EricBabatunde/MaizePlanterRepo/PScontrollerTests/controllerTest2/WhatsApp Image 2026-01-18 at 15.10.30.jpeg

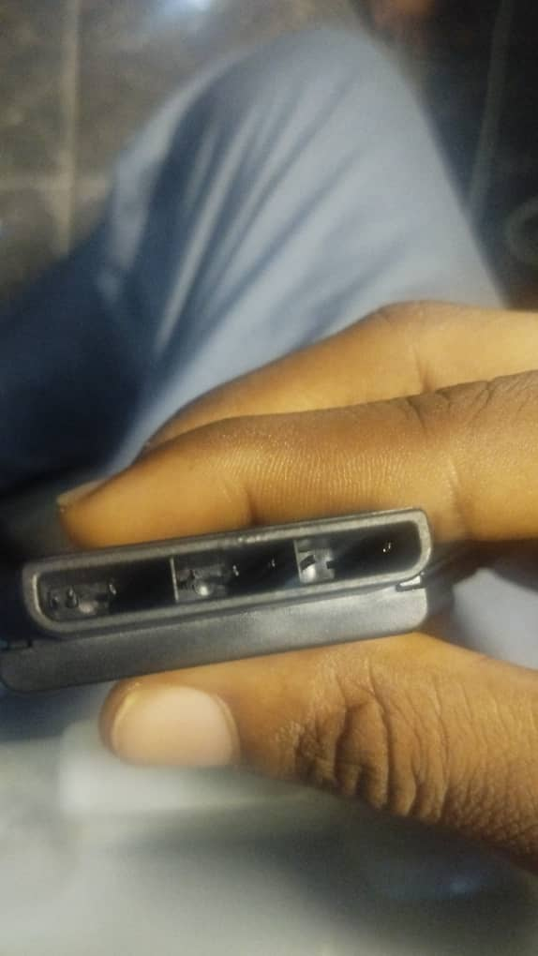
PScontrollerTests/controllerTest2/WhatsApp Image 2026-01-18 at 15.10.30.jpeg
