EricBabatunde/MaizePlanterRepo/PScontrollerTests/controllerTest2/WhatsApp Image 2026-01-18 at 15.08.40.jpeg

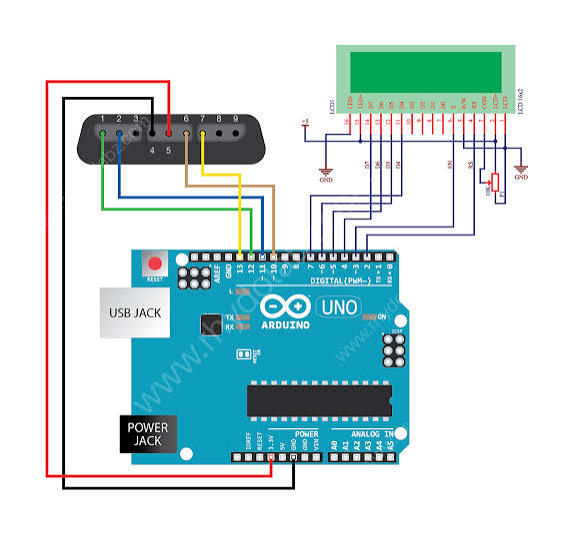
PScontrollerTests/controllerTest2/WhatsApp Image 2026-01-18 at 15.08.40.jpeg
