EricBabatunde/MaizePlanterRepo/README.md

# AutoMaizePublic
This repository contains all the code for the Automated Maize Seed Planter.
