EricBabatunde/MaizePlanterRepo/PScontrollerTests/controllerTest7/Controller controls.pdf

## Controller controls

Input | Function | Logic
Left Stick Y | Left Motor Throttle | Direct control of Left Wheels.
Right Stick Y | Right Motor Throttle | Direct control of Right Wheels.
Difference (L-R) | Press Wheel Angle | Calculates steering angle based on stick difference.
L1 Button | U-Turn Mode | Sets Press Wheel to steering angle, drives right motor and locks left wheel for a left turn
R1 Button | U-Turn Mode | Sets Press Wheel to steering angle, drives left motor and locks right wheel for a left turn
Triangle (Green) | E-Stop / Brake | Immediately cuts power to all motors.
Circle | Planting (Pulse) | Runs metering plate for one cycle (drop seed).
Cross (Blue) | Cruise Control | Locks both motors to Fixed Forward Speed (e.g., planting speed).
