EricBabatunde/MaizePlanterRepo/data analysis/data/TurnTest_Log.csv

Direction | Duration_ms
Pivot_Left | 1267
Pivot_Right | 5150
Pivot_Left | 1919
Pivot_Right | 2237
