EricBabatunde/MaizePlanterRepo/data analysis/data/TurnTest_Run1 (1).csv

Phase | Duration_ms
Deceleration | 1407
Pivot_Left | 8401
Re-alignment | 1802
Acceleration | 801
