EricBabatunde/MaizePlanterRepo/data analysis/data/TurnTest_Run2.csv

Phase | Duration_ms
Deceleration | 1401
Pivot_Right | 8401
Re-alignment | 1801
Acceleration | 801
