EricBabatunde/MaizePlanterRepo/module1_finalv3PIO/module1_finalv3PIO/src/DataLogger.h

#pragma once
#include "Config.h"
#include <Arduino.h>

// Mount LittleFS
void initLogger();

// Generates a new file name and writes the CSV header
void startNewLogFile(String bracketName);

// Appends a new data point to the current run file
void logToFS(int pwm, float speed, float amps);

void logTurnEvent(String direction, unsigned long duration);
void startTelemetryLog();
void logTelemetry(int interval);
void logJamEvent(unsigned long timestamp);
