EricBabatunde/MaizePlanterRepo/(commit log)

2026-06-15 motors control pixhawk arm through remote gcs
2026-06-16 6 tests run - littlefs logs
    [BracketA_Run1 (1).csv, BracketB_Run1 (1).csv, BracketC_Run1 (1).csv, BracketD_Run1 (1).csv, BracketD_Run2.csv, BracketD_Run3.csv, BracketD_Run4.csv, Jam_Events.csv]
2026-06-17 small anti-jam changes
    [CommandLatency_Run1.csv]
2026-06-20 esp32 firmware upgrade with mavlink integration
2026-06-20 ui and littlefs fix
    [NetworkModule.cpp]
2026-06-21 ground speed fix on ui & then some
2026-06-22 as5048a switch to pwm mode
2026-06-23 fixes after test 1
    [MechatronicsModule.cpp, MechatronicsModule.h, NetworkModule.cpp]
2026-06-24 fix path gen maths idle deadlock
    [MechatronicsModule.cpp]
2026-06-24 console debug logs state change fixes
    [MechatronicsModule.cpp]
2026-06-24 turning state fix attempt 1
    [MechatronicsModule.cpp, MechatronicsModule.h]
2026-06-25 5hz telemetry rate thing
2026-06-26 phase 4.1 - ui changes and fixes
    [NetworkModule.cpp, NetworkModule.h]
2026-06-26 phase 4.1 fix 2
    [NetworkModule.cpp]
2026-06-28 good manual fix without arming issue
    [MotorControl.cpp, main.cpp]
